MoonCloud02/RelojAntiguoPereira/(commit log)

2026-01-30 Actualización solo Arduino
2026-02-05 feat: Implementar sistema completo de control con RTC DS3231
    - Actualizar arduino_uno_control.ino:
    * Cambiar a 800,000 pasos/hora (1 revolución completa)
    * Calibrar velocidad a 4,421μs para 1 rev/hora precisa
    * Agregar sincronización rápida (10μs) para recuperación
    * Implementar respaldo EEPROM cada 10 minutos
    * Agregar recuperación automática tras corte de energía
    * Sistema de 12 horas con 9,600,000 pasos totales
    * Acumulador de pasos fraccionarios para precisión
    - Agregar test_motor.ino:
    * Sketch de pruebas y calibración manual
    * Comandos interactivos: FWD, BWD, REV, SPEED, CONT, etc.
    * Medición de tiempos con RTC
    * Velocidad por defecto 4,419μs calibrad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
2026-02-06 Reemplazar EEPROM por tarjeta SD y agregar control de reflector LED
    - Cambiar almacenamiento de posición de EEPROM a tarjeta MicroSD
    - Agregar módulo MicroSD Card Adapter (pin CS en pin 4)
    - Guardar posición cada minuto en archivo position.txt
    - Implementar control automático de reflector LED con relé (pin 7)
    - Reflector se enciende a las 6pm y apaga a las 5am
    - Agregar comandos LIGHT_ON y LIGHT_OFF para control manual
    - Actualizar PULSE_DELAY_US a 1000µs para movimiento más rápido
    - Mejorar feedback en monitor serial para estado del reflector
2026-02-07 Actualizar README con módulo SD, relé y diagrama Mermaid
    - Agregar sección módulo MicroSD Card Adapter con especificaciones
    - Agregar sistema de iluminación automática (6pm-5am)
    - Actualizar tablas de conexión para todos los componentes
    - Convertir diagrama ASCII a Mermaid profesional con colores
    - Agregar precauciones para SD y sistema de iluminación
    - Actualizar comandos disponibles (LIGHT_ON, LIGHT_OFF)
    - Eliminar referencias a ESP32 y comunicación serial
    - Actualizar rutas de documentación técnica
2026-02-07 Corregir lógica del relé para Low Level Trigger
    - Invertir señales de control: LOW=ON, HIGH=OFF
    - Actualizar estado inicial del relé a HIGH (apagado)
    - Corregir comandos LIGHT_ON y LIGHT_OFF
    - Corregir función controlReflector() para lógica invertida
    - Agregar comentarios explicando Low Level Trigger
    - Compatible con relé SSR 2 canales 240V/2A (0-0.5V=ON, 2.5-5V=OFF)
2026-02-07 Implementar wear leveling en SD con 100 slots rotativos
    - Sistema de rotación entre 100 archivos (pos_000.txt a pos_099.txt)
    - Elimina archivo índice para evitar punto único de desgaste
    - Calcula automáticamente siguiente slot desde archivos existentes
    - Busca archivo más reciente por timestamp al iniciar
    - Extiende vida útil de SD de ~2-6 meses a ~19 años
    - Guarda posición con timestamp para verificación de coherencia
    - Agrega información de wear leveling en comando STATUS
    - Correcciones de formato en mensajes del reflector
    - Actualizada documentación en README.md
2026-02-09 Aumentar slots de wear leveling de 100 a 1440
    - 1440 slots = 1 por cada minuto del día (24h 60min)
    - Cada slot se usa solo 1 vez al día
    - Vida útil extendida de ~19 años a ~394 años
    - Cálculo: 1440 slots 100,000 ciclos 1 escritura/día
    - Actualizado formato de nombres: pos_0000.txt a pos_1439.txt (4 dígitos)
    - Distribución óptima del desgaste en la SD
    - La SD durará más que el sistema completo
    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
2026-02-10 Add index and CAD link
2026-02-11 Hora de apagado automatico de los reflectores a las 7am
2026-02-11 Agregar comandos de control de relé a test_motor e invertir dirección del motor
    - Agregados comandos LIGHT_ON/LIGHT_OFF y RELAY_ON/RELAY_OFF en test_motor.ino
    - Añadido PIN_RELAY (pin 7) y variable relayState
    - Estado del relé visible en comando STATUS
    - Actualizada ayuda con nuevos comandos
    - Invertida dirección del motor en arduino_uno_control.ino
    - DIR LOW = adelante (sentido horario), DIR HIGH = atrás
    - Corrige rotación para sentido horario correcto del reloj
    [arduino_uno_control.ino, test_motor.ino]
2026-02-12 Codigo para testeo de la SD y borrado de todos los archivos
2026-02-12 feat: mejorar robustez del control del reloj
    - Reducir PULSE_DELAY_US de 1000 a 500 us para mayor velocidad
    - Agregar monitoreo de minutos perdidos con deteccion de saltos
    - Mejorar gestion de cortes de energia con menu interactivo (SYNC/COMP/OK)
    - Mantener motor habilitado permanentemente (holding torque)
    - Agregar comando COMP para compensar minutos desde ultimo guardado
    - Implementar reintentos y verificacion de integridad en escritura SD
    - Agregar mensajes de depuracion para guardado en SD
    - Mostrar contador de actualizaciones en STATUS
    - Eliminar testSDCard() y showSDInfo() para reducir uso de flash
2026-04-07 fix: corregir bugs y refactorizar movimiento no bloqueante
    - Corregir STEPS_PER_MINUTE a división flotante (60.0f) para que el
    acumulador de pasos fraccionarios funcione correctamente
    - Reemplazar moveSteps() bloqueante por sistema de lotes no bloqueante
    (processPendingSteps, 200 pasos por iteración) eliminando bloqueos
    de hasta 9 minutos durante sincronización completa
    - Corregir parámetro por defecto duplicado en declaración y definición
    de moveSteps
    - Guardar en SD al completar movimiento en vez de bloqueante inline
    - Agregar guard diff==0 en performFullSync para evitar pendingOnComplete sucio
    - Agregar guards de pendingSteps en comandos SYNC, COMP y RESET
    - Eliminar comando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
    [arduino_uno_control.ino]
2026-04-08 feat: agregar watchdog timer para operación 24/7 sin supervisión
    - Agregar watchdog de 8 segundos para reinicio automático ante cuelgues
    - Reemplazar halt permanente en fallo de RTC por reset controlado vía watchdog
    - Alimentar watchdog en loop(), wait de 60s y scan de 1440 slots en SD
    - Deshabilitar WDT al inicio de setup() para evitar resets durante inicialización
    [arduino_uno_control.ino]
2026-04-08 fix: resincronizar a hora actual cuando se detectan minutos saltados
    Si un movimiento largo (ej. primera sync) tarda más de un minuto,
    el reloj quedaba atrasado porque solo avanzaba un minuto al terminar.
    Ahora se fuerza performFullSync() cuando se detectan minutos saltados,
    corrigiendo la posición a la hora real del RTC.
    [arduino_uno_control.ino]
2026-04-08 docs: actualizar README con cambios del firmware
    - Corregir horario reflector de 6pm-5am a 6pm-7am en todos los lugares
    - Actualizar lista de comandos: quitar ENABLE/DISABLE, agregar COMP
    - Corregir responsabilidades del Arduino: EN siempre activo para holding torque 24/7
    - Actualizar lógica de funcionamiento del RTC con nuevos comportamientos
    - Agregar sección de nuevas protecciones: watchdog, movimiento no bloqueante,
    resincronización automática y verificación de escritura SD
    - Corregir cálculo de vida útil SD: 10 años y 394 años → 273 años
    - Actualizar fecha de última actualización
2026-04-10 fix: corregir problemas de robustez para operación 24/7
    - Eliminar uso de String dinámico en favor de char[] estáticos para
    evitar fragmentación del heap en el path de SD y Serial
    - Agregar wdt_reset() dentro de savePositionToSD() para evitar reset
    del watchdog durante operaciones lentas de SD
    - Usar strtoul() en lugar de toInt() para timestamps unsigned long
    - Introducir flag sdAvailable para reinicializar SD.begin() solo cuando
    es necesario, no en cada escritura
    - Reemplazar detección de minutos saltados por comparación de timestamps
    Unix completos para cubrir saltos entre horas
    - Redondear en calculateStepsForTime() con +0.5f en lugar de truncar
    [arduino_uno_control.ino]
2026-04-10 docs: actualizar README con mejoras de robustez del firmware
    Reflejar los fixes aplicados al firmware para operación 24/7:
    - Detección de minutos saltados ahora usa timestamps Unix completos
    - WDT alimentado dentro de operaciones SD
    - SD solo se reinicializa ante errores reales
    - Sin fragmentación de heap: char[] estáticos en lugar de String
2026-04-10 fix: eliminar debug, corregir underflow y precision en stepsToTime
    - Eliminar mensaje [DEBUG] de moveOneMinute() que bloqueaba Serial
    brevemente cada minuto en produccion
    - Agregar guardia contra underflow unsigned en setup cuando el RTC
    tiene fecha anterior al ultimo guardado en SD
    - Usar aritmetica entera con redondeo en stepsToTime() para evitar
    error de display por precision float en comando STATUS
    [arduino_uno_control.ino]
2026-04-10 fix: guardar posicion en SD tras COMP en el arranque
    Si el usuario elegía COMP durante el boot y luego había un corte de
    luz antes del primer tick de minuto, la compensación se perdía al
    reiniciar. Ahora se llama savePositionToSD() inmediatamente después
    de actualizar la posición.
    [arduino_uno_control.ino]
2026-04-10 refactor: eliminar comando COMP por ser imposible en este hardware
    El motor solo avanza si el Arduino genera pulsos. No existe escenario
    donde el motor haya avanzado sin que el Arduino lo haya contabilizado,
    por lo que COMP no tenia utilidad real y podia causar desincronizacion
    si se usaba por error tras un corte de luz.
    Se simplifica el menu de arranque a SYNC / OK y se elimina COMP del
    handler de comandos en tiempo de ejecucion.
    [arduino_uno_control.ino]
2026-04-10 fix: corregir direction, heap, overflow y interrupcion en test_motor
    - Corregir convenio de direccion: adelante = LOW en PIN_DIR, igual
    que arduino_uno_control (antes era HIGH, opuesto al firmware real)
    - Reemplazar String con char[] para evitar fragmentacion de heap
    - Agregar guard rtcAvailable para no llamar rtc.now() si RTC fallo
    - Agregar check de overflow en REV (maximo 2684 revoluciones)
    - Detectar comando STOP cada 1000 pasos en moveSteps() para poder
    interrumpir movimientos largos sin resetear el Arduino
    - DISABLE ahora limpia continuousMode correctamente
    [test_motor.ino]
